Amanyamuramu/programmable-ball-repository/cad/stl/v4/basestation v2.stl

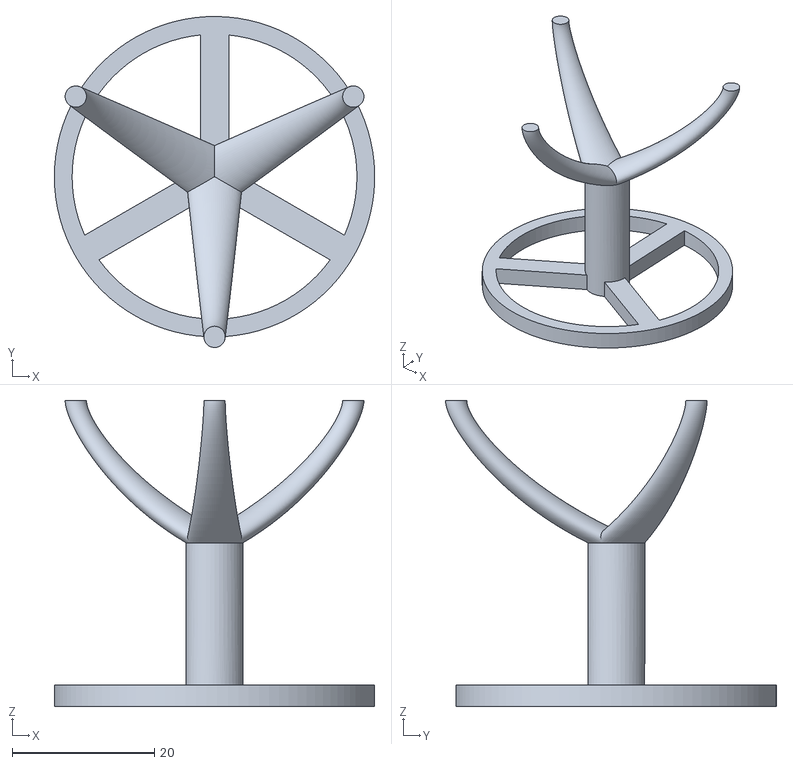
[picture p1: CAD file, 2024-07-06]
cad/stl/v4/basestation v2.stl
45.0 x 46.5 x 43.0
