Amanyamuramu/programmable-ball-repository/cad/stl/v4/cap v1.stl

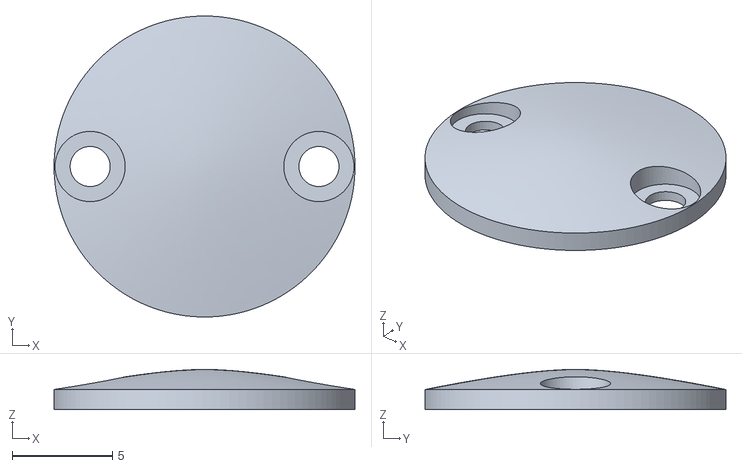
[picture p2: CAD file, 2024-07-06]
cad/stl/v4/cap v1.stl
15.0 x 15.0 x 2.00
