Amanyamuramu/programmable-ball-repository/cad/stl/v4/コンポーネント2 v1.stl

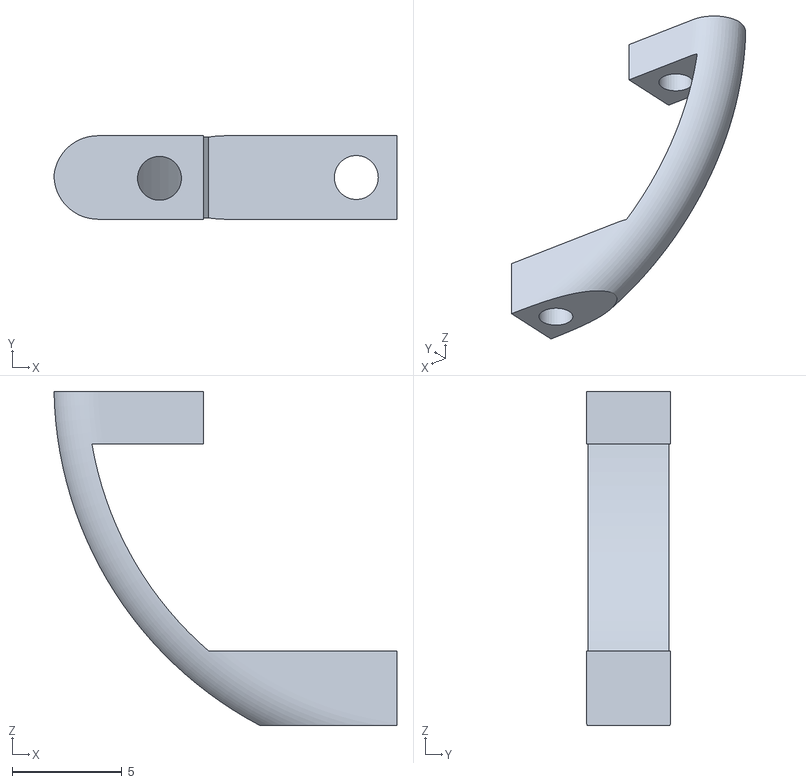
[picture p3: CAD file, 2024-07-06]
cad/stl/v4/コンポーネント2 v1.stl
15.6 x 3.80 x 15.2
