Amanyamuramu/programmable-ball-repository/cad/stl/v4/ball_outside_bottom v3.stl

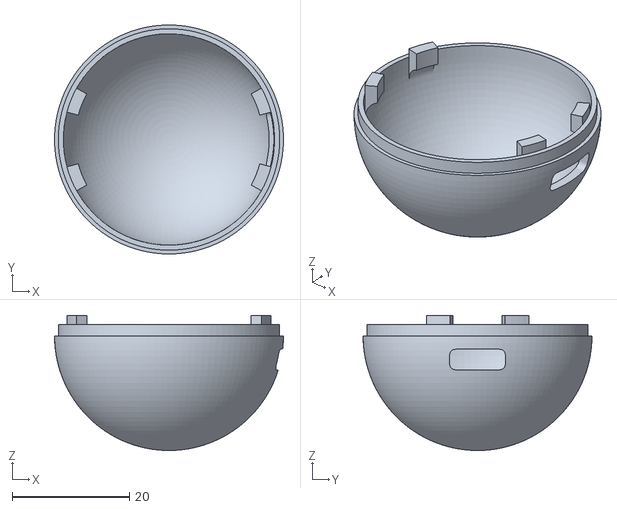
[picture p4: CAD file, 2024-07-06]
cad/stl/v4/ball_outside_bottom v3.stl
39.0 x 39.0 x 23.0
