Amanyamuramu/programmable-ball-repository/cad/stl/v4/pb_frame v3.stl

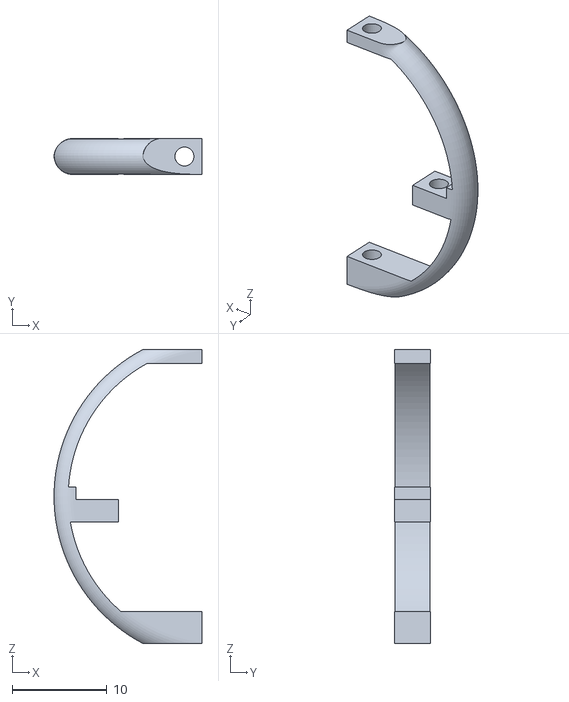
[picture p5: CAD file, 2024-07-06]
cad/stl/v4/pb_frame v3.stl
15.6 x 3.80 x 31.0
