Amanyamuramu/programmable-ball-repository/cad/stl/v1/programmableBall_surface_pb_maindisk v1.stl

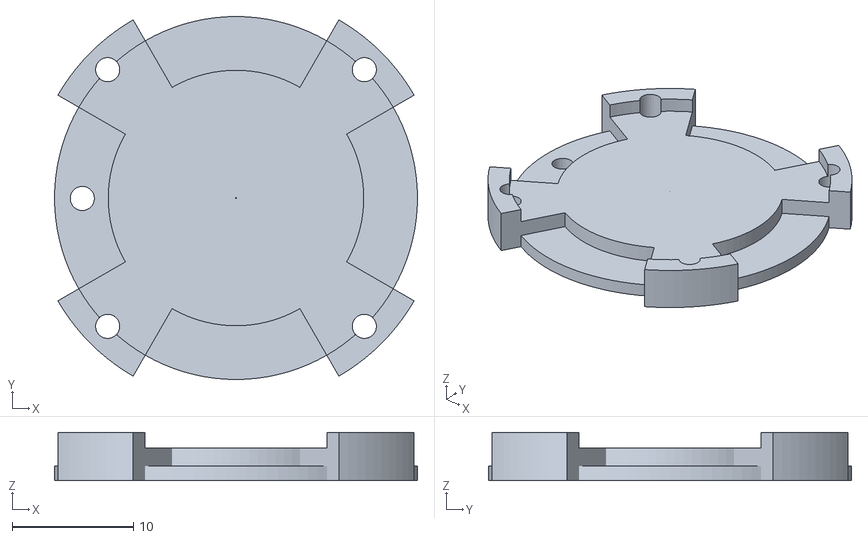
[picture p7: CAD file, 2024-03-28, an earlier design]
cad/stl/v1/programmableBall_surface_pb_maindisk v1.stl
30.0 x 30.0 x 4.00
