Amanyamuramu/programmable-ball-repository/cad/stl/v3/pb_maindisk v2.stl

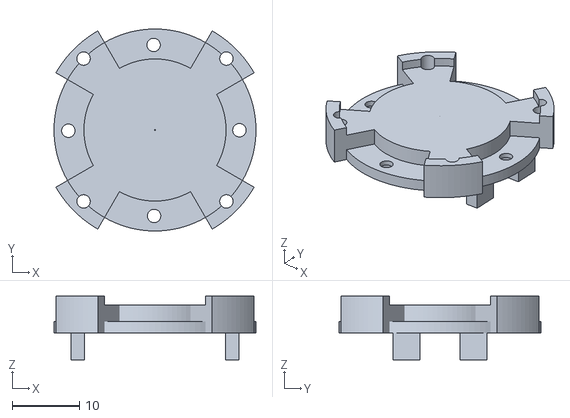
[picture p8: CAD file, 2024-04-08, an earlier design]
cad/stl/v3/pb_maindisk v2.stl
30.0 x 30.0 x 9.50
