Amanyamuramu/programmable-ball-repository/cad/stl/v2/programmableBall_surface_pb_maindisk v2.stl

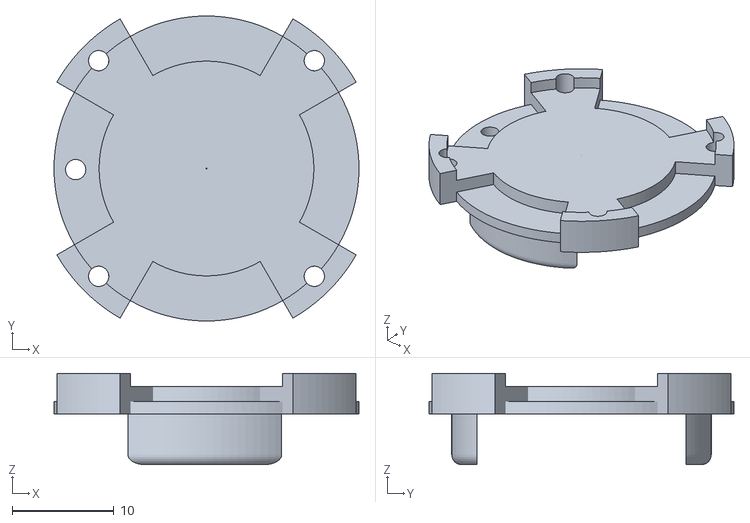
[picture p9: CAD file, 2024-04-08, an earlier design]
cad/stl/v2/programmableBall_surface_pb_maindisk v2.stl
30.0 x 30.0 x 9.00
