Amanyamuramu/programmable-ball-repository/cad/stl/v2/programmableBall_surface_pb_subdisk_2.stl

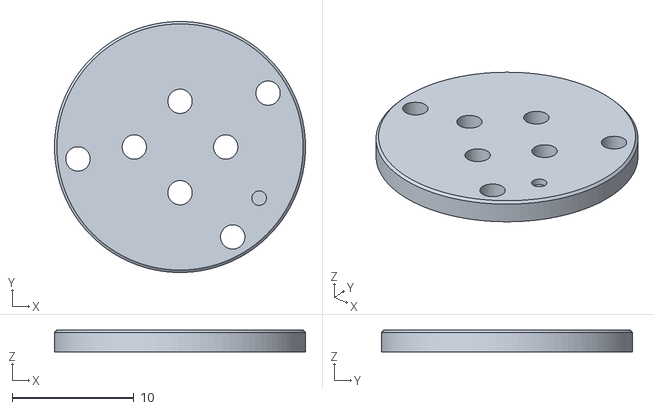
[picture p10: CAD file, 2024-04-08, an earlier design]
cad/stl/v2/programmableBall_surface_pb_subdisk_2.stl
20.6 x 20.6 x 1.80
