Amanyamuramu/programmable-ball-repository/cad/stl/v3/pb_subdisk v2.stl

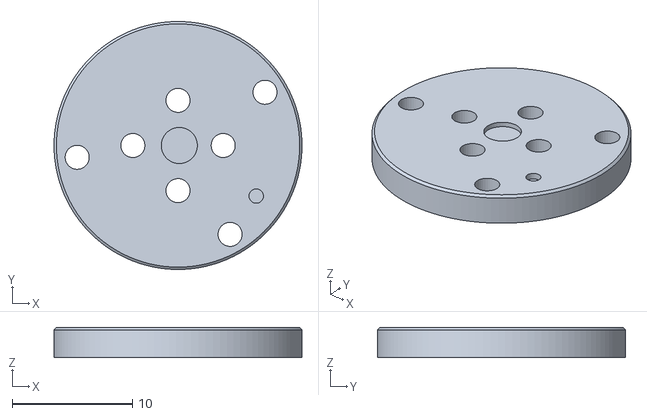
[picture p11: CAD file, 2024-04-08, an earlier design]
cad/stl/v3/pb_subdisk v2.stl
20.6 x 20.6 x 2.50
