Amanyamuramu/programmable-ball-repository/cad/stl/v1/programmableBall_surface_pb_subdisk v1.stl

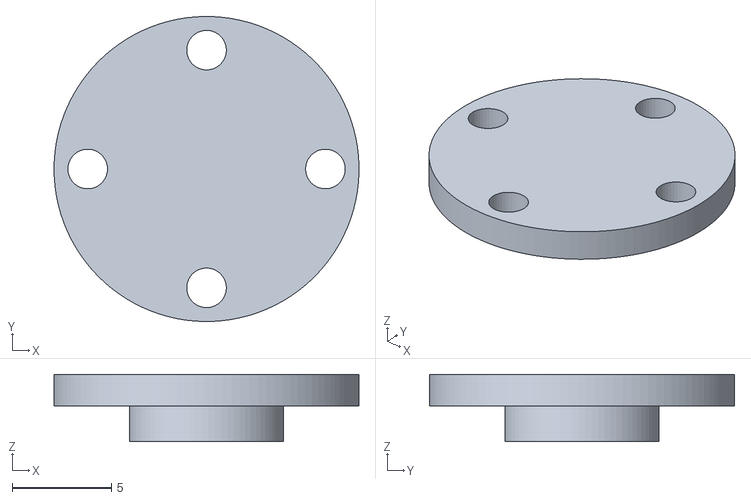
[picture p12: CAD file, 2024-03-28, an earlier design]
cad/stl/v1/programmableBall_surface_pb_subdisk v1.stl
15.4 x 15.4 x 3.40
