Amanyamuramu/programmable-ball-repository/cad/stl/v2/programmableBall_surface_pb_frame v2.stl

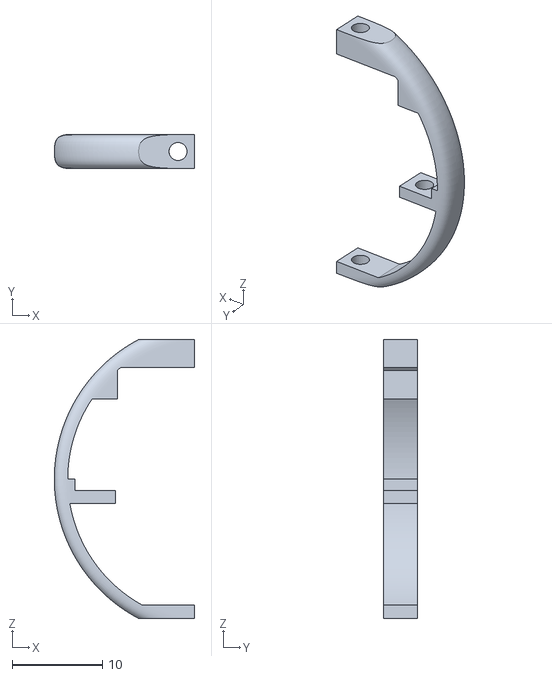
[picture p13: CAD file, 2024-04-08, an earlier design]
cad/stl/v2/programmableBall_surface_pb_frame v2.stl
15.6 x 3.80 x 31.0
