Amanyamuramu/programmable-ball-repository/cad/stl/v4/ball_outside_bottom v2.stl

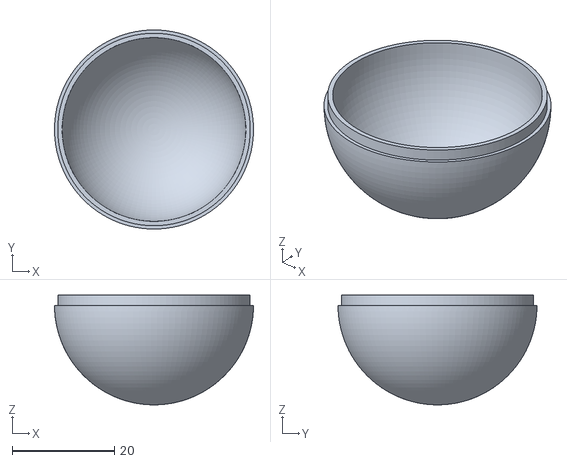
[picture p14: CAD file, 2024-07-06, an earlier design]
cad/stl/v4/ball_outside_bottom v2.stl
39.0 x 39.0 x 21.5
