Amanyamuramu/programmable-ball-repository/cad/stl/v1/programmableBall_surface_pb_cap v1.stl

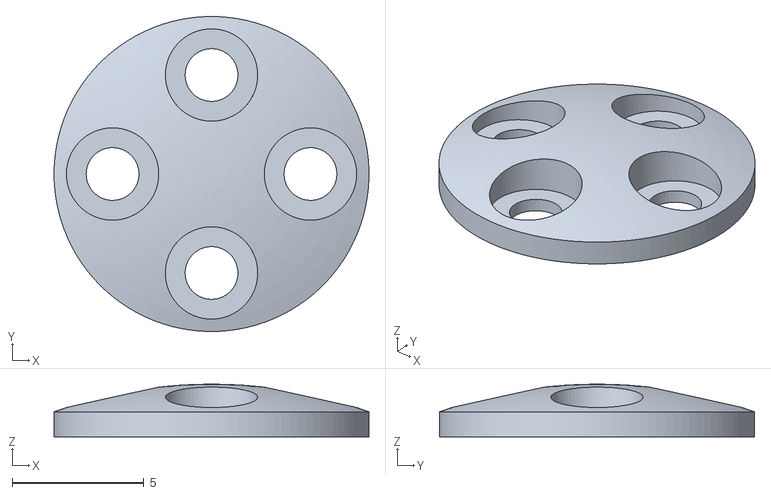
[picture p15: CAD file, 2024-03-28, an earlier design]
cad/stl/v1/programmableBall_surface_pb_cap v1.stl
11.9 x 11.9 x 2.00
