Amanyamuramu/programmable-ball-repository/cad/stl/v3/pb_cap v2.stl

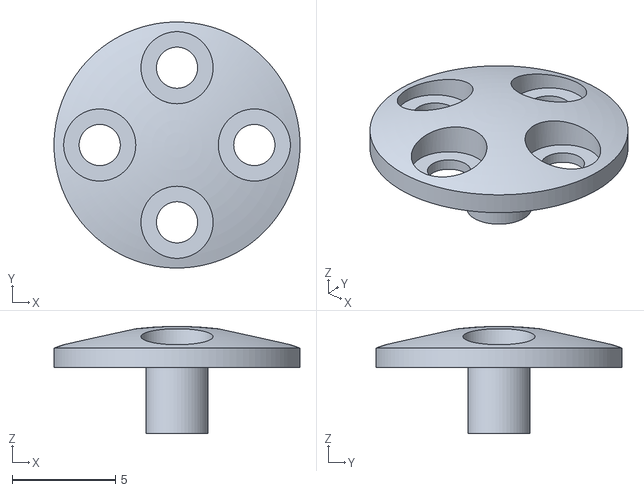
[picture p17: CAD file, 2024-04-08, an earlier design]
cad/stl/v3/pb_cap v2.stl
11.9 x 11.9 x 5.20
