Amanyamuramu/programmable-ball-repository/cad/stl/v1/programmableBall_surface_pb_frame v1.stl

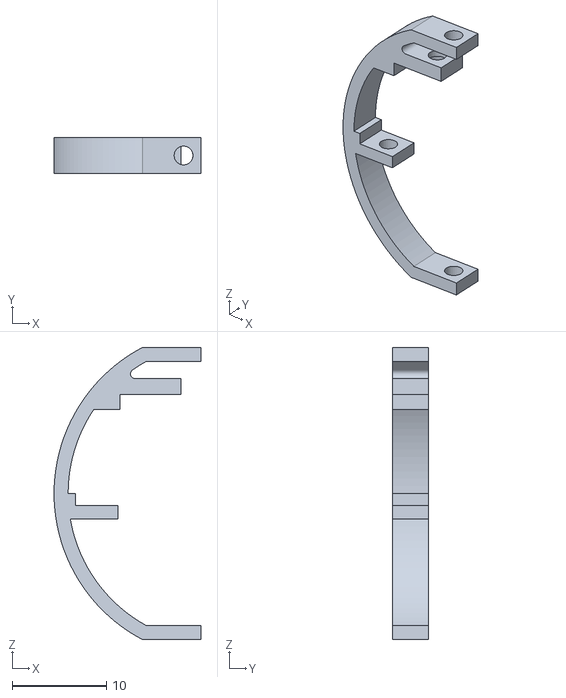
[picture p18: CAD file, 2024-03-28, an earlier design]
cad/stl/v1/programmableBall_surface_pb_frame v1.stl
15.6 x 3.80 x 31.0
