Amanyamuramu/programmable-ball-repository/(list of files, cad)

Other CAD files:
cad/stl/v2/programmableBall_surface_pb_cap v1.stl
cad/stl/v3/pb_assembled.f3z
cad/stl/v3/pb_cap2 v1.stl
cad/stl/v3/pb_frame v4.stl
cad/stl/v4/ball_outside_uppder v1.stl
cad/stl/v4/コンポーネント2.f3d
