Amanyamuramu/programmable-ball-repository/pcb/programmable-ball_sub/SubProgrammableBall.brd

## EAGLE design pcb/programmable-ball_sub/SubProgrammableBall.brd (2024-04-08)

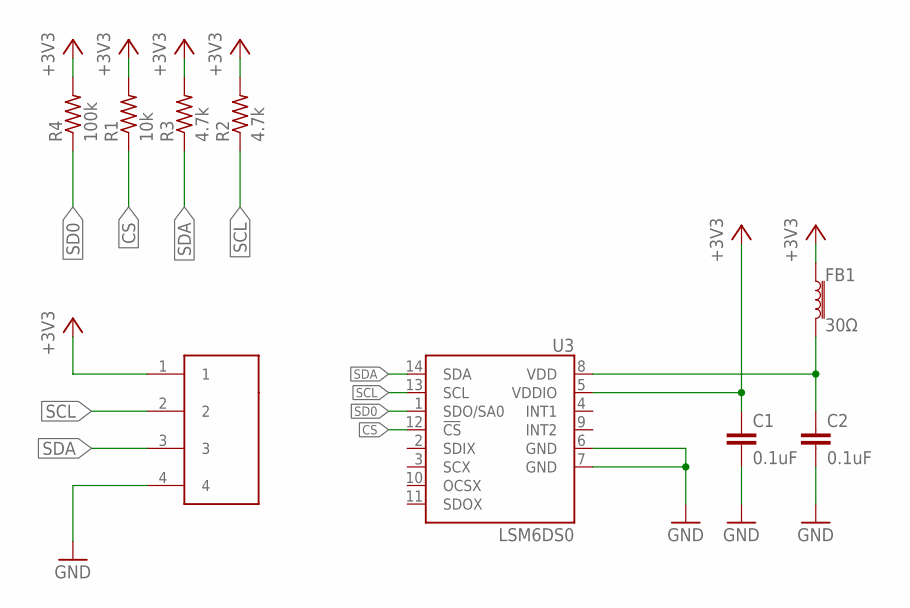
[picture p19: schematic SubProgrammableBall.sch]

Parts:
C1, C2: 0.1uF; C0603
CON1: B4B-ZR-SM4-TF; CONN_B4B-ZR-SM4-TF
FB1: 30Ω; 0603
R1: 10k; R0603
R2, R3: 4.7k; R0603
R4: 100k; R0603
U3: LSM6DS0; LGA14L

Connections:
+3V3: C1.1, CON1.1, FB1.1, R1.2, R2.2, R3.2, R4.2, U3.5 (VDDIO)
CS: R1.1, U3.12 (!CS!)
GND: C1.2, C2.2, CON1.4, U3.6 (GND), U3.7 (GND)
unnamed: C2.1, FB1.2, U3.8 (VDD)
SCL: CON1.2, R2.1, U3.13 (SCL)
SD0: R4.1, U3.1 (SDO/SA0)
SDA: CON1.3, R3.1, U3.14 (SDA)

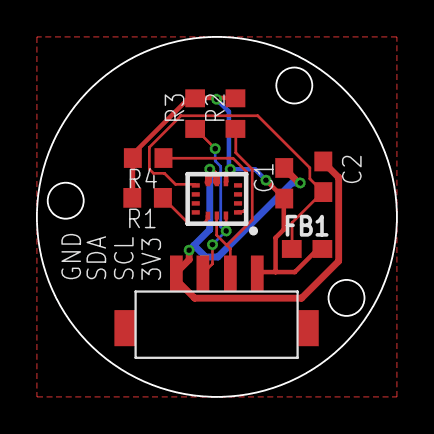
[picture p20: board SubProgrammableBall.brd from above]

Board: 2 copper layers, 20.0 x 20.0 mm, 9 parts (0 on the bottom side), 7 nets.
