Amanyamuramu/programmable-ball-repository/pcb/programmable-ball_main/programmable-ball_main.brd

## EAGLE design pcb/programmable-ball_main/programmable-ball_main.brd (2024-03-18)

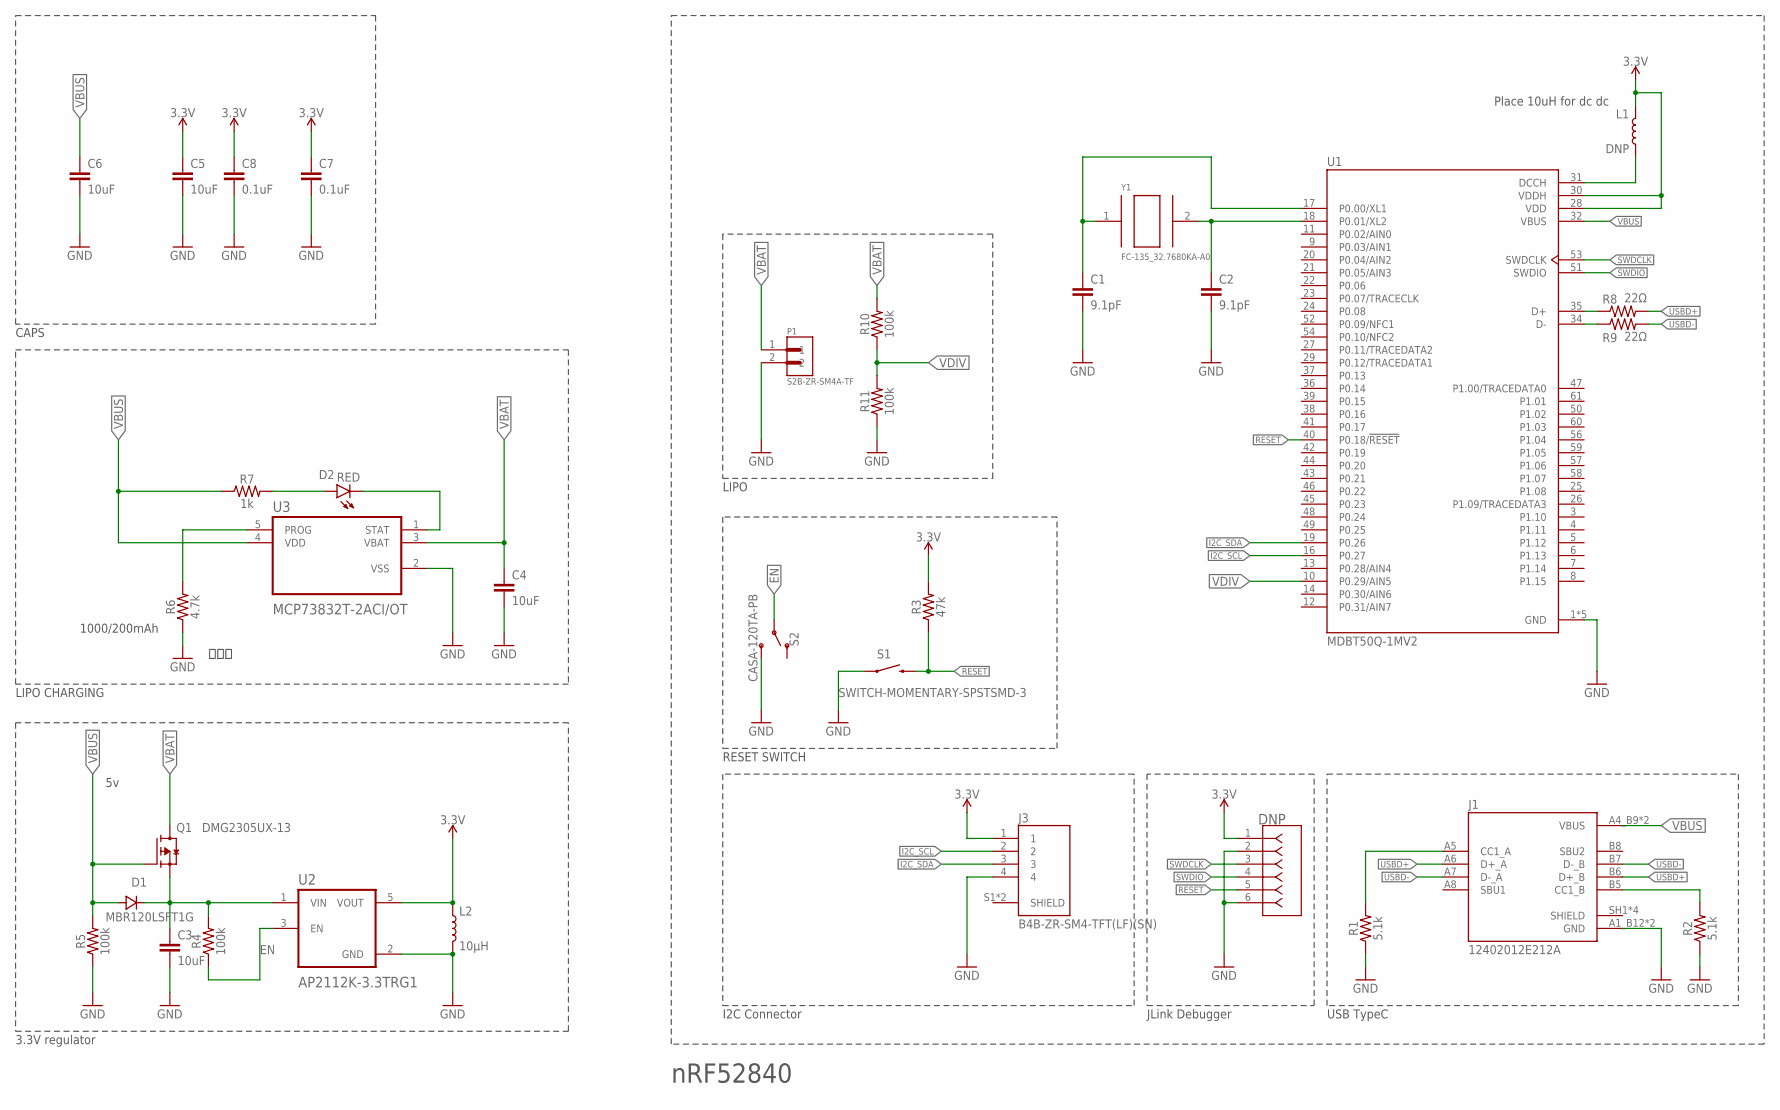
[picture p21: schematic programmable-ball_main.sch]

Parts:
C1, C2: 9.1pF; 0402-TIGHT
C3, C4, C5, C6: 10uF; 0603
C7, C8: 0.1uF; 0402-TIGHT
D1: MBR120LSFT1G; SOD323
D2: RED; LED-0402
DNP: 84981-6RE; 84981-6
J1: 12402012E212A; AMPHENOL_12402012E212A
J3: B4B-ZR-SM4-TFT(LF)(SN); JST_B4B-ZR-SM4-TFT(LF)(SN)
L1: DNP; 0805
L2: 10μH; 0805
P1: S2B-ZR-SM4A-TF; JST_S2B-ZR-SM4A-TF
Q1: DMG2305UX-13; SOT91P240X110-3N
R1, R2: 5.1k; 0402-TIGHT
R3: 47k; 0402-TIGHT
R4, R5, R10, R11: 100k; 0402-TIGHT
R6: 4.7k; 0402-TIGHT
R7: 1k; 0402-TIGHT
R8, R9: 22Ω; 0402-TIGHT
S1: SWITCH-MOMENTARY-SPSTSMD-3; TACTILE_SWITCH_SMD-3
S2: CASA-120TA-PB; CAS-120A
U1: MDBT50Q-1MV2; XCVR_MDBT50Q-1MV2
U2: AP2112K-3.3TRG1; SOT95P285X140-5N
U3: MCP73832T-2ACI/OT; SOT95P270X145-5N
Y1: FC-135_32.7680KA-A0; XTAL_FC-135_32.7680KA-A0

Connections:
3.3V: C5.1, C7.1, C8.1, DNP.1, J3.1, L1.1, L2.1, R3.2, U1.28 (VDD), U1.30 (VDDH), U2.5 (VOUT)
EN: R4.1, S2.2, U2.3 (EN)
GND: C1.2, C2.2, C3.2, C4.2, C5.2, C6.2, C7.2, C8.2, DNP.2, DNP.6, J1.A1_B12 (GND), J1.B1_A12 (GND), J3.4, L2.2, P1.2, R1.1, R2.1, R5.1, R6.1, R11.1, S1.1, S2.3 (S), U1.1 (GND), U1.2 (GND), U1.15 (GND), U1.33 (GND), U1.55 (GND), U2.2 (GND), U3.2 (VSS)
I2C_SCL: J3.2, U1.16 (P0.27)
I2C_SDA: J3.3, U1.19 (P0.26)
unnamed: J1.A5 (CC1_A), R1.2
unnamed: J1.B5 (CC1_B), R2.2
unnamed: C2.1, U1.18 (P0.01/XL2), Y1.2
unnamed: C1.1, U1.17 (P0.00/XL1), Y1.1
unnamed: L1.2, U1.31 (DCCH)
unnamed: C3.1, D1.1 (C), Q1.2 (S), R4.2, U2.1 (VIN)
unnamed: R6.2, U3.5 (PROG)
unnamed: D2.C, U3.1 (STAT)
unnamed: D2.A, R7.2
unnamed: R8.1, U1.35 (D+)
unnamed: R9.1, U1.34 (D-)
RESET: DNP.5, R3.1, S1.4 (2), U1.40 (P0.18/!RESET)
SWDCLK: DNP.3, U1.53 (SWDCLK)
SWDIO: DNP.4, U1.51 (SWDIO)
USBD+: J1.A6 (D+_A), J1.B6 (D+_B), R8.2
USBD-: J1.A7 (D-_A), J1.B7 (D-_B), R9.2
VBAT: C4.1, P1.1, Q1.3 (D), R10.2, U3.3 (VBAT)
VBUS: C6.1, D1.2 (A), J1.A4_B9 (VBUS), J1.B4_A9 (VBUS), Q1.1 (G), R5.2, R7.1, U1.32 (VBUS), U3.4 (VDD)
VDIV: R10.1, R11.2, U1.10 (P0.29/AIN5)

Notes on the sheet:
nRF52840
電源系
USB TypeC
JLink Debugger
RESET SWITCH
LIPO
Place 10uH for dc dc
3.3V regulator
LIPO CHARGING
1000/200mAh
I2C Connector
CAPS

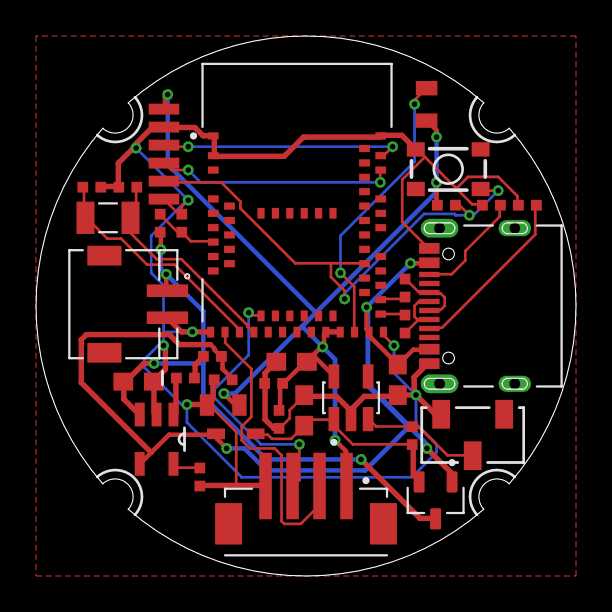
[picture p22: board programmable-ball_main.brd from above]

Board: 2 copper layers, 30.0 x 30.0 mm, 34 parts (0 on the bottom side), 24 nets.
