Amanyamuramu/programmable-ball-repository/(threads)

Thread 4 (2024-03-01):

回路図の設計

Amanyamuramu, 2024-03-01:
###  メイン回路として以下の機能を搭載した回路図を作成
- マイコン
- リポ 充放電用素子
- LED（バッテ残量のインジケータ）
- USBコネクタ（type-C）
- reset用タクトスイッチ

Amanyamuramu, 2024-03-08:
v1完成

Closed 2024-03-08.
