Amanyamuramu/programmable-ball-repository/fw/programmable_ball_project/src/main.cpp

#include <Arduino.h>
#include <Adafruit_TinyUSB.h>
#include "BLEHelper.h"
#include "Filters.h"
#include "SparkFunLSM6DSO.h"
#include "Wire.h"

BleHelper ble;
Filters filter;
LSM6DSO myIMU; //Default constructor is I2C, addr 0x6B

float prev_rms = 0;
unsigned long previousMillis = 0;
float prev_acc_data[3] = {0};
unsigned long timeVoltageCheck = millis();
const float RMS_THRESHOLD = 3;//3は衝撃（1.5は机に置くなど）

//プロトタイプ宣言
bool checkButtonRelease(const int pin);
void accInit();
float accDiff();
float getBatteryVoltage();
float batteryPercentage(float voltage);

void setup()
{
  Serial.begin(115200);
  ble.init();
  analogReadResolution(10);
  pinMode(PIN_AIN5, INPUT);
  /*
  pinMode(PIN_WIRE_SCL, INPUT_PULLUP);
  pinMode(PIN_WIRE_SDA, INPUT_PULLUP);
  */
  Wire.begin();
  delay(500);
  accInit();
}

void loop()
{
  /*LSM6DSOの出力確認
  Serial.println(myIMU.readFloatAccelX(), 3);
  Serial.println(myIMU.readFloatAccelY(), 3);
  Serial.println(myIMU.readFloatAccelZ(), 3);
  */
  float rms = accDiff();
  //fixme:rmsの閾値の調整（衝突の大きさの分類）
  if(rms>=RMS_THRESHOLD){
    Serial.print("RMS: ");
    Serial.println(rms, 3); // RMSの値を表示
    unsigned long currentMillis = millis();
    if(currentMillis - previousMillis >= 150){//チャタリング防止
      char checkType[2] = "M";

      char zero[2] = "0";
      char myChar[5];
      sprintf(myChar, "%s %s", checkType,zero); 
      ble.write(myChar);

      char one[2] = "1";
      sprintf(myChar, "%s %s", checkType,one);
      ble.write(myChar);
      previousMillis = millis();
    }
  }

    //電圧値の更新(rmsの確認)
  if(millis() - timeVoltageCheck > 1000){
    float vol = getBatteryVoltage();
    float per = batteryPercentage(vol);
    //値の送信
    char checkType[2] = "B";
    char myChar[20];
    sprintf(myChar, "%s %2.2f", checkType,per); 
    ble.write(myChar);
    timeVoltageCheck = millis();

    // Serial.print("RMS: ");
    // Serial.println(rms, 3); // RMSの値を表示

    char texAcc[20];
    float accX = myIMU.readFloatAccelX();
    float accY = myIMU.readFloatAccelY();
    float accZ = myIMU.readFloatAccelZ();
    sprintf(texAcc, "A %2.2f %2.2f %2.2f", accX, accY, accZ);
    ble.write(texAcc);
  }
}

void accInit(){
  //LSM6DSOのセットアップ
  if( myIMU.begin(0x6B))//0x6B default, 0x6A(sa0 is gnd)
    Serial.println("Ready.");
  else { 
    Serial.println("Could not connect to IMU.");
  }
  if( myIMU.initialize(BASIC_SETTINGS) ){
    Serial.println("Loaded Settings.");
  }
  float imu_data[3] = {myIMU.readFloatAccelX(), myIMU.readFloatAccelY(), myIMU.readFloatAccelZ()};
  for(uint8_t i = 0; i < 3; i++){
    prev_acc_data[i] = imu_data[i];
    Serial.print(imu_data[i]); Serial.print(", ");
  }
  prev_rms = sqrt((pow(imu_data[0], 2) + pow(imu_data[1], 2) + pow(imu_data[2], 2)) / 3);
  Serial.print("Initial RMS: ");
  Serial.println(prev_rms);
}

float accDiff(){
  float imu_data[3] = {myIMU.readFloatAccelX(), myIMU.readFloatAccelY(), myIMU.readFloatAccelZ()};
  float lpf[3] = {0};
  float hpf[3] = {0};
  for (uint8_t i = 0; i < 3; i++){
    lpf[i] = filter.applyLowPassFilter(imu_data[i], prev_acc_data[i]);
    prev_acc_data[i] = imu_data[i];
    hpf[i] = filter.applyHighPassFilter(imu_data[i], lpf[i]);
  }
  float rms = sqrt((pow(hpf[0], 2) + pow(hpf[1], 2) + pow(hpf[2], 2)) / 3);
  return rms;
}

// VBAT
float getBatteryVoltage()
{
  const float referenceVoltage = 3.3; // ADC reference voltage
  const int resolution = 1023; //2^10
  const float R1 = 100000.0; // divided register's upper value
  const float R2 = 100000.0; // under value
  const float voltageDividerRatio = R2 / (R1 + R2);

  int sensorValue = analogRead(PIN_AIN5);
  float voltage = sensorValue * (referenceVoltage / resolution);
  return voltage / voltageDividerRatio; // 分圧比でスケーリング
}

float batteryPercentage(float voltage) {
  const float fullChargeVoltage = 4.2;  // バッテリーのフルチャージ電圧
  const float dischargeVoltage = 3.0;  // 安全な放電限界電圧

  if (voltage >= fullChargeVoltage) {
    return 100.0;  // 100% charged
  } else if (voltage <= dischargeVoltage) {
    return 0.0;  // Completely discharged
  } else {
    float percentage = (voltage - dischargeVoltage) / (fullChargeVoltage - dischargeVoltage) * 100.0;
    return percentage;  // 現在の残量をパーセンテージで計算
  }
}
