Amanyamuramu/programmable-ball-repository/(commit log)

2024-02-23 Added BLE接続用ブラウザ
2024-02-23 Added mp3 free素材
2024-02-23 modify html button appearance
2024-02-23 acc取得してBLEに流す用のFW追加
2024-02-23 加速度センサが動くコード。rmsの計算・シリアルの出力がされる
2024-02-23 動作用に処理修正
2024-02-23 Added acc sensor lib
2024-02-23 RMSの処理を追加
2024-02-23 軽微な修正
2024-02-25 filterモジュールを追加
2024-02-25 ハイパス後の加速度ローデータを用いてRMSに反映するように変更
2024-03-01 メイン回路のプロジェクト作成
    [programmable-ball_main.brd, programmable-ball_main.sch]
2024-03-01 nRFを基板に搭載し、大きさ見てみた #4
    [programmable-ball_main.brd, programmable-ball_main.sch]
2024-03-01 軽微な修正 #4
    [programmable-ball_main.brd, programmable-ball_main.sch]
2024-03-01 vscode以下を管理対象外に設定
2024-03-02 Added Circular Board and TypeC Connector #4
    [programmable-ball_main.brd, programmable-ball_main.sch]
2024-03-02 試し用のガーバーデータ書き出し
2024-03-02 usb typeC周り実装 #4
    [programmable-ball_main.brd, programmable-ball_main.sch]
2024-03-02 スイッチを追加 #4
    [programmable-ball_main.brd, programmable-ball_main.sch]
2024-03-03 3.3VのレギュレータとVBATよりVBUSを優先するように修正
    [programmable-ball_main.brd, programmable-ball_main.sch]
2024-03-03 スライドスイッチを追加 #4
    [programmable-ball_main.brd, programmable-ball_main.sch]
2024-03-03 配置を微修正
    [programmable-ball_main.brd]
2024-03-03 主電源スイッチとリポ充放電素子を追加 #4
    [programmable-ball_main.brd, programmable-ball_main.sch]
2024-03-04 リポ充放電機能を搭載 #4
    [programmable-ball_main.brd, programmable-ball_main.sch]
2024-03-05 パターンの位置調整
    [programmable-ball_main.brd, programmable-ball_main.sch]
2024-03-07 コネクタとコンデンサを追加 #4
    [programmable-ball_main.brd, programmable-ball_main.sch]
2024-03-08 基盤外形を変更
    [programmable-ball_main.brd]
2024-03-08 基盤外形追加
2024-03-08 基板v1完成 resolved #4
    [programmable-ball_main.brd, programmable-ball_main.sch]
2024-03-08 v1のガーバーデータ書き出し
2024-03-10 v1の修正
    [programmable-ball_main.brd, programmable-ball_main.sch]
2024-03-10 パターン調整前を最新版に変更
    [programmable-ball_main.brd]
2024-03-10 v2の軽微な修正
    [programmable-ball_main.brd]
2024-03-10 v2ガーバーデータ書き出し
2024-03-13 sub基板のbrd上で部品配置まで。これから配線
    [SubProgrammableBall.brd, SubProgrammableBall.sch]
2024-03-14 brd, schの更新
    [SubProgrammableBall.brd, SubProgrammableBall.sch]
2024-03-14 ベタ変更
    [SubProgrammableBall.brd, SubProgrammableBall.sch]
2024-03-18 シルクの削除
    [programmable-ball_main.brd, programmable-ball_main.sch]
2024-03-18 最新版に変更
    [programmable-ball_main.brd]
2024-03-18 最終版(v3)のガーバーデータ書き出し
2024-03-18 サブ基板のガーバーデータ書き出し
2024-03-18 発注用のガーバーデータを専用フォルダに移動
2024-03-28 筐体のためのSTL追加
    [programmableBall_surface_pb_cap v1.stl, programmableBall_surface_pb_frame v1.stl, programmableBall_surface_pb_maindisk v1.stl, programmableBall_surface_pb_subdisk v1.stl]
2024-04-06 加速度センサのfoot print間違い修正
    [SubProgrammableBall.brd, SubProgrammableBall.sch]
2024-04-06 筐体のstl追加
    [pb_cap v2.stl, pb_cap2 v1.stl, pb_frame v4.stl, pb_maindisk v2.stl, pb_subdisk v2.stl, programmableBall_surface_pb_cap v1.stl, programmableBall_surface_pb_frame v2.stl, programmableBall_surface_pb_maindisk v2.stl]
2024-04-08 バッテリ残量が表示されるように修正
2024-04-08 added battery appearance in html
2024-05-29 LSM6DSOを使用するために整理
2024-05-29 i2cスキャナーを追加
2024-05-29 不要な処理はコメントアウト
2024-05-29 加速度センサLSM6DSOに対応するように修正
2024-05-29 rmsの値をシリアルにて確認できるように修正
2024-05-29 文章を微修正
2024-05-29 mp3のデータ追加
2024-05-29 mp3データと連続処理の追加
2024-05-29 組み立て完成後のアセンブリファイル追加
    [pb_assembled.f3z]
2024-05-29 パスを変更
2024-05-29 ランダムのバージョンに戻した
2024-05-29 通信用データ接頭辞に文字記号を追加
2024-05-30 テキストの条件分岐に半角の空白を追加
2024-05-30 ポーリングに変更，不要なシリアル出力を削除
2024-05-30 ポーリング形式に修正，不要なシリアル出力を削除
2024-05-30 ジャイロ描画用のスクリプト作成
2024-06-03 ボール外形用3Dデータ追加
    [ball_outside_bottom v2.stl, ball_outside_bottom v3.stl, ball_outside_uppder v1.stl, ball_outside_uppder v3.stl, cap v1.stl, pb_frame v3.stl, コンポーネント2 v1.stl, コンポーネント2.f3d]
2024-06-03 unity Projectと音声ファイルを無視
2024-07-06 効果音追加
2024-07-06 fw修正
2024-07-06 音声読み込みソース変更
2024-07-06 rmsの閾値強度を変更
2024-07-06 音ファイルを変更
2024-07-06 twitterの着信に変更
